skot/bitcrane/doc/bitcrane.jpg

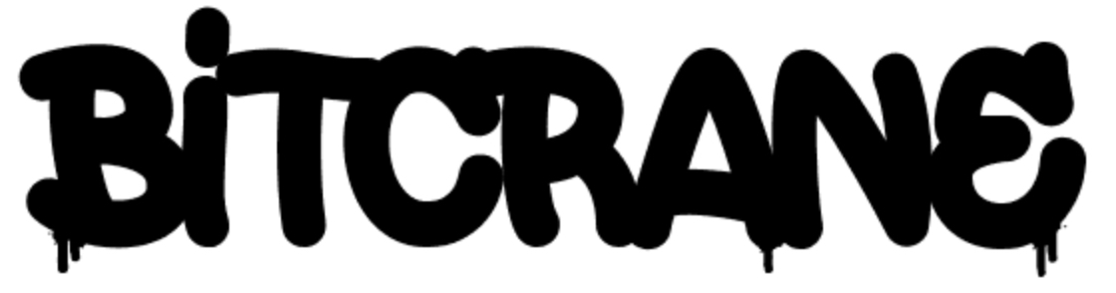
doc/bitcrane.jpg
