skot/bitcrane/3d/RGV0016A.stp

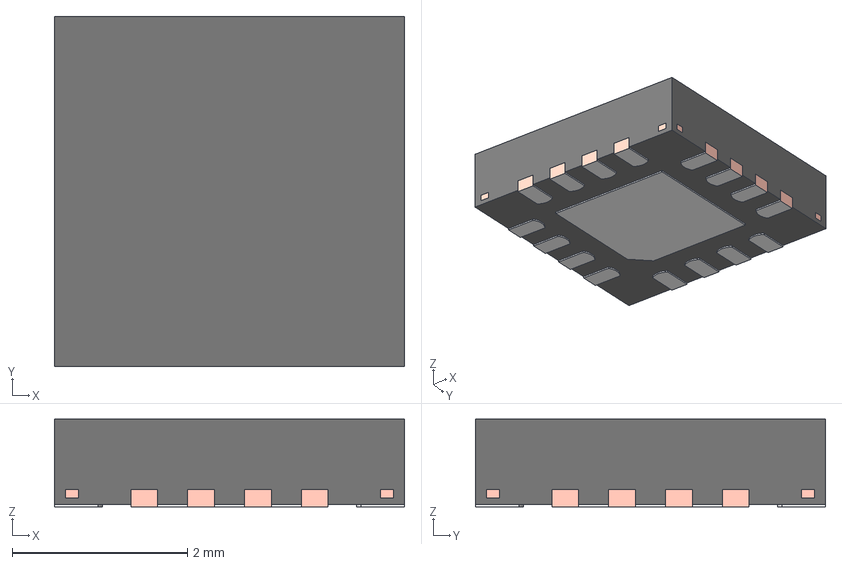
[picture p2: CAD file, 2023-12-09]
3d/RGV0016A.stp
4.00 x 4.00 x 1.00 mm
FRAME
PIN1_AREA
