skot/bitcrane/3d/TSOT-23-5_RIT.step

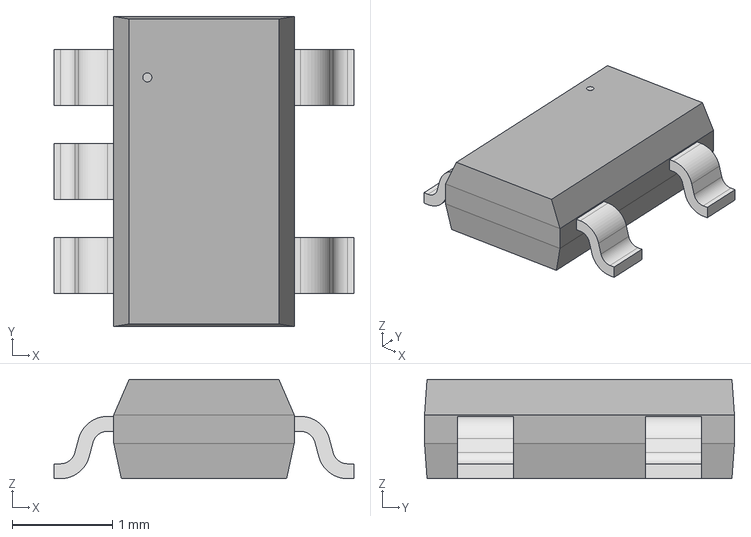
[picture p3: CAD file, 2023-10-24]
3d/TSOT-23-5_RIT.step
3.00 x 3.10 x 0.993 mm
