skot/bitcrane/3d/PowerDI3333-8_Type-UX.STP

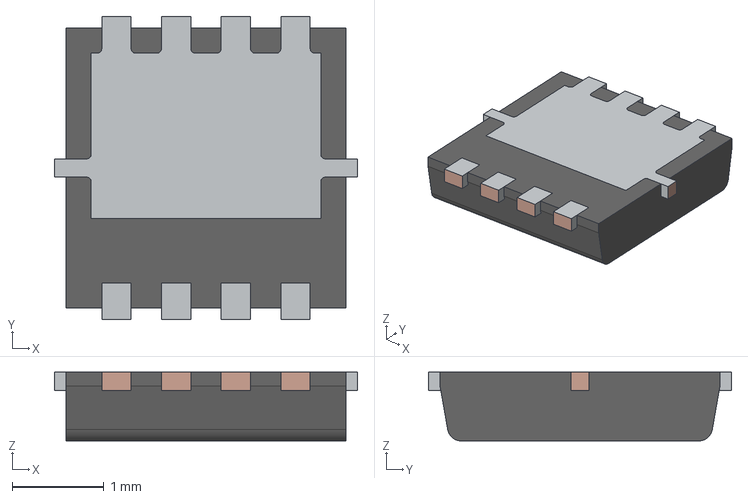
[picture p4: CAD file, 2023-10-24]
3d/PowerDI3333-8_Type-UX.STP
3.30 x 3.30 x 0.75 mm
Mold
LDF
