skot/bitcrane/3d/ABM8W-12.0000MHZ-7-K1Z-T3.step

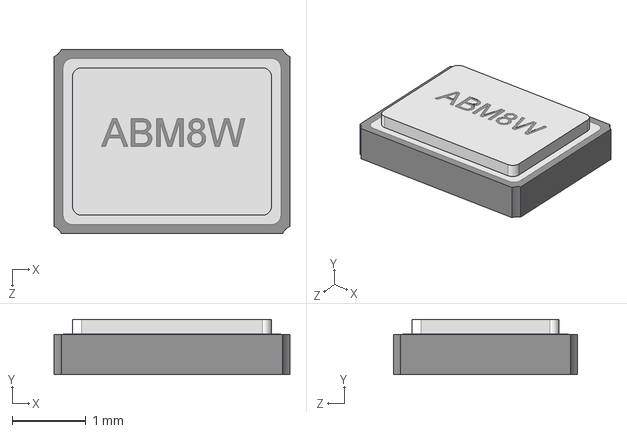
[picture p5: CAD file, 2023-10-23]
3d/ABM8W-12.0000MHZ-7-K1Z-T3.step
3.20 x 0.75 x 2.50 mm
