skot/bitcrane/3d/405C35B12M00000.step

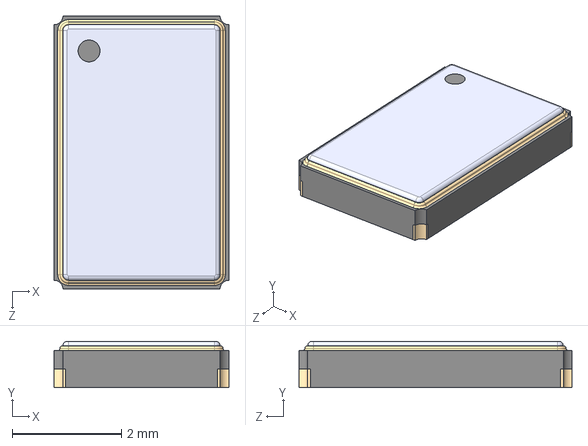
[picture p6: CAD file, 2023-10-23]
3d/405C35B12M00000.step
3.20 x 0.85 x 5.00 mm
