skot/bitcrane/3d/FT4232HQ-REEL.step

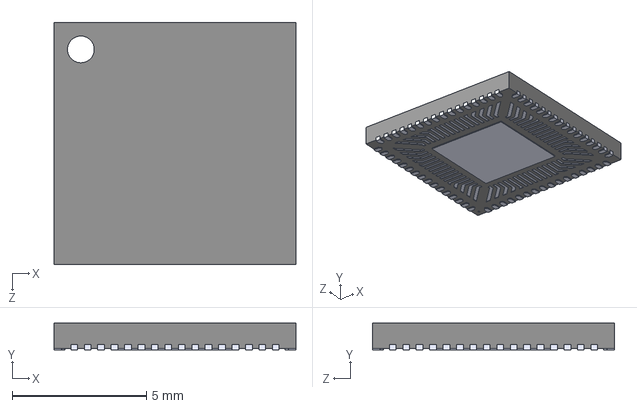
[picture p7: CAD file, 2023-10-23]
3d/FT4232HQ-REEL.step
9.00 x 1.00 x 9.00 mm
