skot/bitcrane/3d/TSSOP8_STM.step

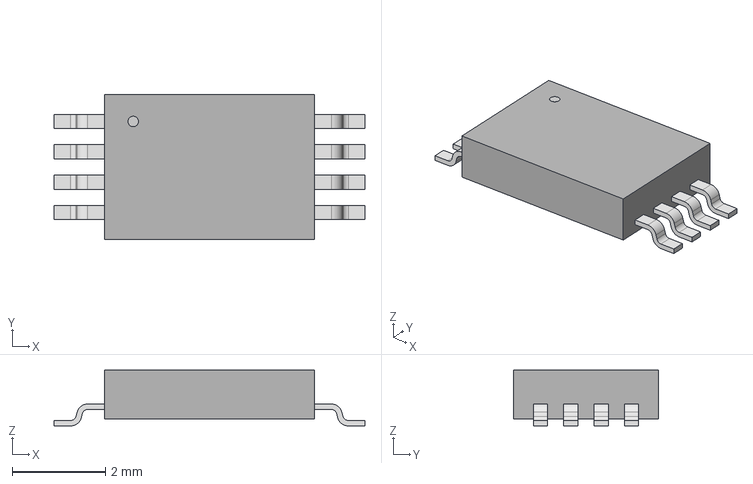
[picture p8: CAD file, 2023-10-23]
3d/TSSOP8_STM.step
6.65 x 3.10 x 1.20 mm
