skot/bitcrane/3d/45558-0003.stp

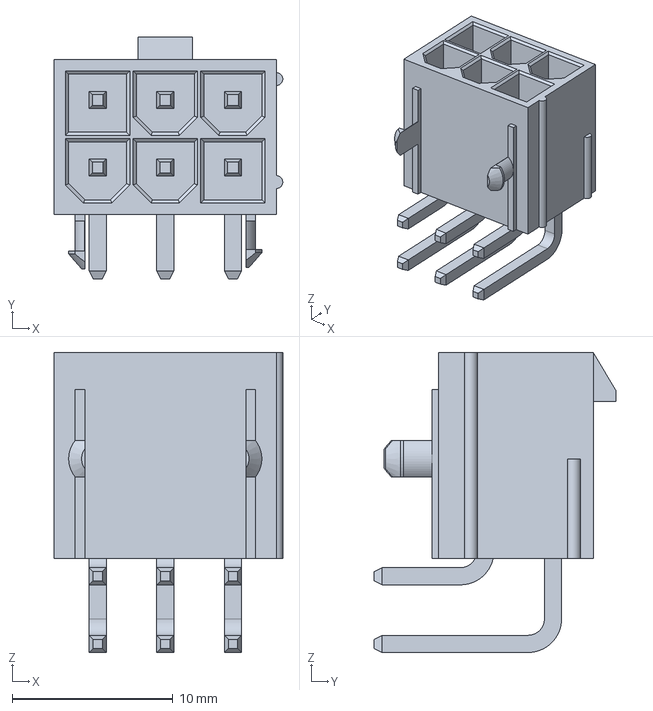
[picture p9: CAD file, 2023-10-24]
3d/45558-0003.stp
14.2 x 15.0 x 18.6 mm
