skot/bitcrane/3d/61900411021.stp

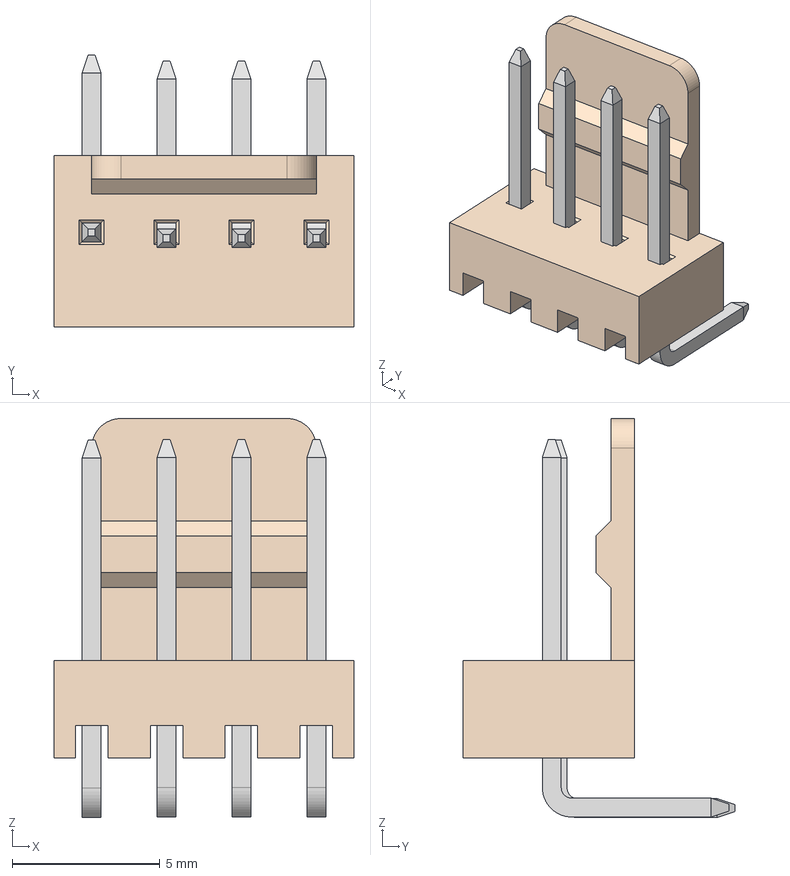
[picture p10: CAD file, 2023-10-24]
3d/61900411021.stp
10.2 x 9.20 x 13.5 mm
6190xx1xx21_PIN x 4
