skot/bitcrane/3d/353180420.igs

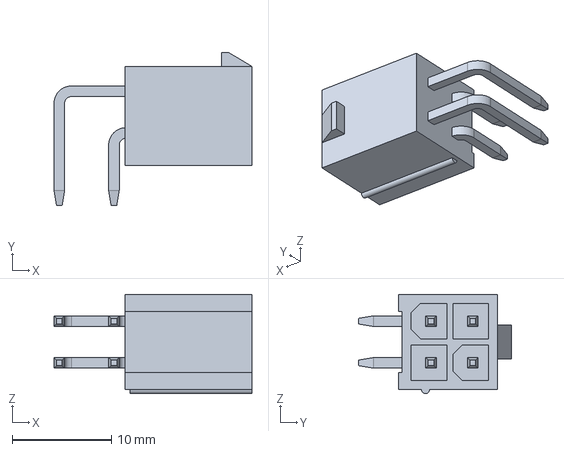
[picture p11: CAD file, 2023-10-24]
3d/353180420.igs
19.9 x 15.4 x 10.0 mm
