skot/bitcrane/bitcrane.kicad_pcb

## KiCad design bitcrane.kicad_pcb (2024-05-23)

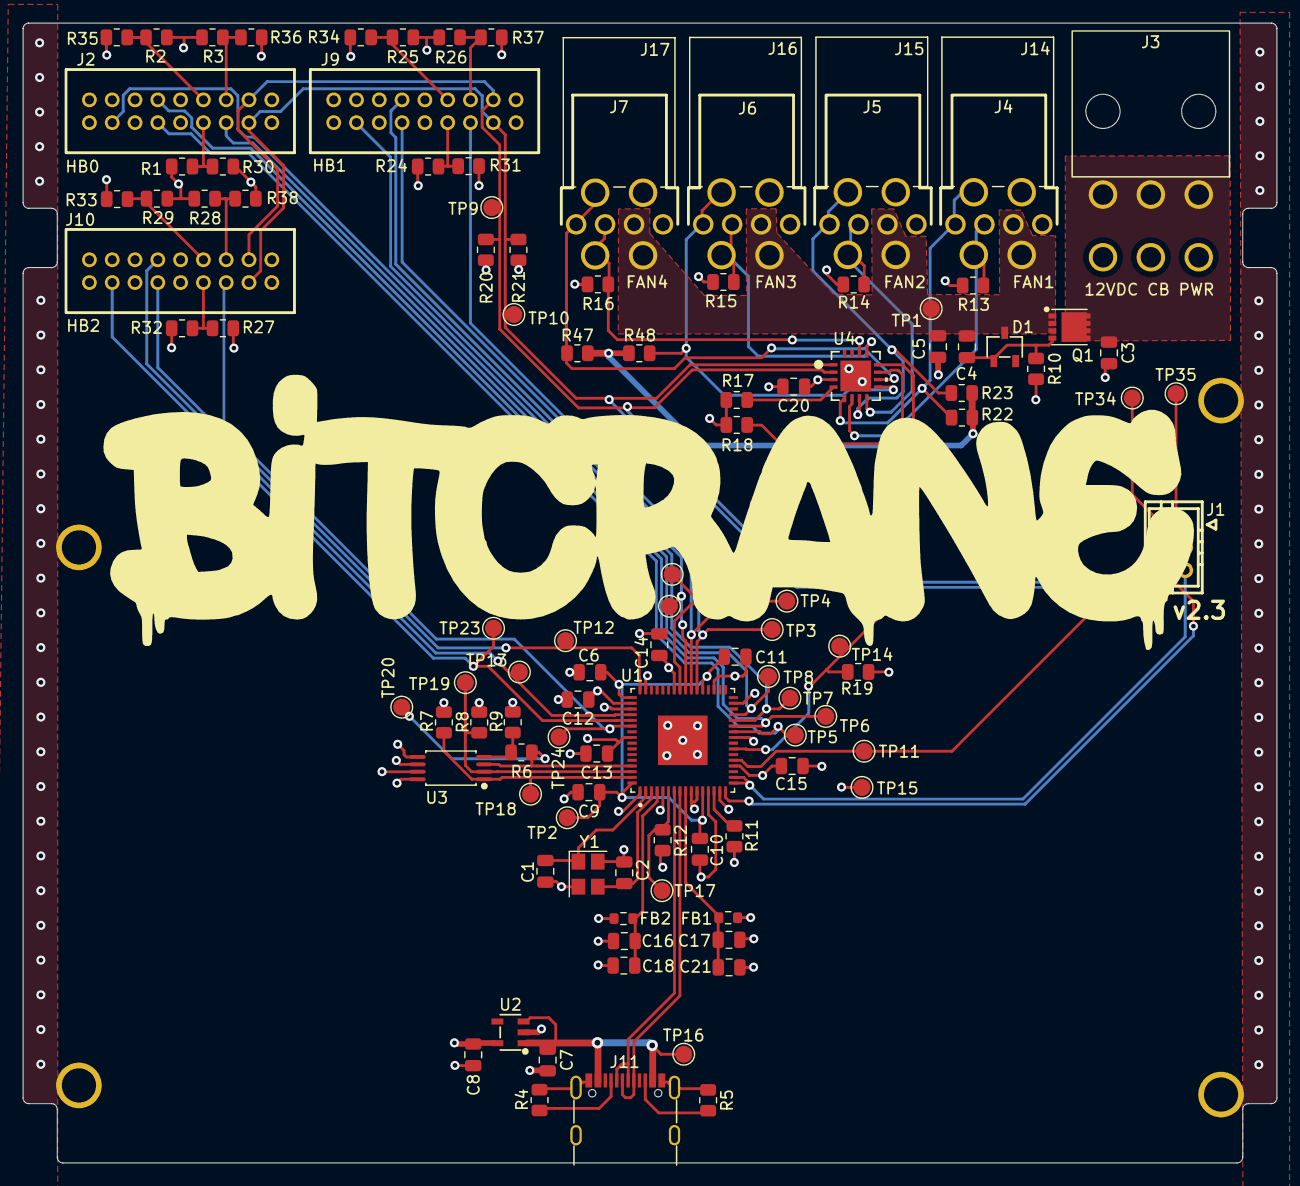
[picture p12: board bitcrane.kicad_pcb from above]

Board: 4 copper layers, 110.0 x 100.0 mm, 113 parts (0 on the bottom side), 58 nets.

Parts:
C1, C2: 27pf; C_0805_2012Metric
C3, C4, C9, C10, C11, C12, C13, C14, C15, C16, C17, C20: 0.1uF; C_0805_2012Metric
C5: 10uF 35V; C_0805_2012Metric
C6: 3.3uF; C_0805_2012Metric
C7, C8: 1uF; C_0805_2012Metric
C18, C21: 47uF; C_0805_2012Metric
D1: LBZX84C12LT1G; SOT-23-3_L2.9-W1.6-P1.90-LS2.8-BR
FB1, FB2: FerriteBead_Small; R_0603_1608Metric
H1, H2, H3, H4: MountingHole_Pad; MountingHole_3mm_Pad
J1: PSU Comm; CONN-TH_6P-P2.00_PHD-2X3A
J2, J9, J10: 2x9P 2mm; CONN-TH_X2026WV-2-09D-46SN
J3: 0455580003; CONN-TH_50362462
J4, J5, J6, J7: 61900411021; CONN-TH_4P-P2.54_HCTL_HC-2510-4AW
J11: USB_C_Receptacle_USB2.0; USB-C-SMD_G-SWITCH_GT-USB-7010ASV
J14, J15, J16, J17: 0353180420; CONN-TH_4P-P4.20_5557-2X2AW
Q1: DMP3013SFV-7; POWERPAK-1212-8_L3.1-W3.1-P0.65-LS3.3-BL
R1, R2, R3, R19, R20, R21, R24, R25, R26, R27, R28, R29, R30, R31, R32, R33, R34, R35, R36, R37, R38: 4.7k; R_0805_2012Metric
R4, R5: 5.1k; R_0805_2012Metric
R6: 2.2k; R_0805_2012Metric
R7, R8, R9, R22, R23, R47, R48: 10k; R_0805_2012Metric
R10, R12: 12k; R_0805_2012Metric
R11: 1k; R_0805_2012Metric
R13, R14, R15, R16: 36k; R_0805_2012Metric
R17: 33k; R_0805_2012Metric
R18: 22k; R_0805_2012Metric
TP1, TP2, TP3, TP4, TP5, TP6, TP7, TP8, TP9, TP10, TP11, TP12, TP13, TP14, TP15, TP16, TP17, TP18, TP19, TP20, TP21, TP22, TP23, TP24, TP34, TP35: TestPoint; TestPoint_Pad_D1.5mm
U1: FT4232HQ; QFN50P900X900X105-65N
U2: RT9080-33GJ5; TSOT-23-5_L2.9-W1.6-P0.95-LS2.8-BL
U3: M93C46-WDW6TP; TSSOP-8_L4.4-W3.0-P0.65-LS6.4-BL
U4: EMC2305; QFN16_4x4MC_MCH
Y1: 12MHz; Crystal_SMD_3225-4Pin_3.2x2.5mm

Connections:
/5V: C7.1, J11.A4B9 (VBUS), J11.B4A9 (VBUS), R22.2, R23.2, R47.2, R48.2, TP16.1, U2.1 (VIN), U2.3 (EN)
/12V: C4.1, C5.1, D1.3 (K), J4.2, J5.2, J6.2, J7.2, J14.2, J15.2, J16.2, J17.2, Q1.1 (S), Q1.2 (S), Q1.3 (S), TP1.1
/A00: J2.8, R2.1, R35.2
/A01: J9.8, R25.1, R34.2
/A02: J10.8, R28.1, R33.2
/A10: J2.7, R1.2, R30.2
/A11: J9.7, R24.2, R31.2
/A12: J10.7, R27.2, R32.2
/A20: J2.6, R3.1, R36.2
/A21: J9.6, R26.1, R37.2
/A22: J10.6, R29.1, R38.2
/FAN_ALERT: R19.1, TP14.1, U1.23 (ADBUS6), U4.12 (~ALERT)
/PLUG0: J2.5, TP8.1, U1.29 (BDBUS3)
/PLUG1: J9.5, TP22.1, U1.41 (CDBUS3)
/PLUG2: J10.5, TP24.1, U1.54 (DDBUS3)
/PSU_EN: J1.5, TP11.1, U1.21 (ADBUS4)
/PWM1: J4.4, J14.4, R22.1, U4.5 (PWM1)
/PWM2: J5.4, J15.4, R23.1, U4.7 (PWM2)
/PWM3: J6.4, J16.4, R47.1, U4.9 (PWM3)
/PWM4: J7.4, J17.4, R48.1, U4.13 (PWM4)
/RST0: J2.15, TP7.1, U1.28 (BDBUS2)
/RST1: J9.15, TP21.1, U1.40 (CDBUS2)
/RST2: J10.15, TP23.1, U1.53 (DDBUS2)
/RXD0: J2.12, TP6.1, U1.27 (BDBUS1)
/RXD1: J9.12, TP4.1, U1.39 (CDBUS1)
/RXD2: J10.12, TP13.1, U1.52 (DDBUS1)
/SCL: J1.6, J2.4, J9.4, J10.4, R20.1, TP9.1, U1.16 (ADBUS0), U4.2 (SMCLK)
/SDA: J1.3, J2.3, J9.3, J10.3, R21.1, TP10.1, U1.17 (ADBUS1), U1.18 (ADBUS2), U4.1 (SMDATA)
/TACH1: J4.3, J14.3, R13.2, U4.6 (TACH1)
/TACH2: J5.3, J15.3, R14.2, U4.8 (TACH2)
/TACH3: J6.3, J16.3, R15.2, U4.10 (TACH3)
/TACH4: J7.3, J17.3, R16.2, U4.14 (TACH4)
/TXD0: J2.11, TP5.1, U1.26 (BDBUS0)
/TXD1: J9.11, TP3.1, U1.38 (CDBUS0)
/TXD2: J10.11, TP12.1, U1.48 (DDBUS0)
GND: C1.2, C2.2, C3.2, C5.2, C6.2, C7.2, C8.2, C9.2, C10.2, C11.2, C12.2, C13.2, C14.2, C15.2, C16.2, C17.2, C18.2, C20.2, C21.2, H1.1, H2.1, H3.1, H4.1, J1.2, J2.1, J2.2, J2.9, J2.10, J2.13, J2.14, J3.4, J3.5, J3.6, J4.1, J5.1, J6.1, J7.1, J9.1, J9.2, J9.9, J9.10, J9.13, J9.14, J10.1, J10.2, J10.9, J10.10, J10.13, J10.14, J11.1 (SHELL), J11.2 (SHELL), J11.3 (SHELL), J11.4 (SHELL), J11.A1B12 (GND), J11.B1A12 (GND), J14.1, J15.1, J16.1, J17.1, R1.1, R2.2, R3.2, R4.1, R5.1, R10.2, R12.1, R24.1, R25.2, R26.2, R27.1, R28.2, R29.2, U1.1 (GND), U1.5 (GND), U1.10 (AGND), U1.11 (GND), U1.13 (TEST), U1.15 (GND), U1.25 (GND), U1.35 (GND), U1.47 (GND), U1.51 (GND), U1.65 (EPAD), U2.2 (GND), U3.5 (VSS), U3.7 (DU), U4.17 (GND), Y1.2 (GND), Y1.4 (GND__1)
unnamed: C3.1, J3.1, J3.2, J3.3, Q1.5 (D), Q1.6 (D), Q1.7 (D), Q1.8 (D)
unnamed: C4.2, D1.1 (A), Q1.4 (G), R10.1
unnamed: J1.1, TP35.1
unnamed: J1.4, TP34.1
unnamed: J11.A5 (CC1), R4.2
unnamed: J11.B5 (CC2), R5.2
unnamed: J11.A7 (DN1), J11.B7 (DN2), U1.7 (DM)
unnamed: J11.A6 (DP1), J11.B6 (DP2), U1.8 (DP)
unnamed: R8.1, TP19.1, U1.62 (EECLK), U3.2 (CLK)
unnamed: R7.1, TP18.1, U1.63 (EECS), U3.1 (CS)
unnamed: R6.2, TP20.1, U1.61 (EEDATA), U3.3 (D)
unnamed: C1.1, U1.2 (OSCI), Y1.1
unnamed: C2.1, U1.3 (OSCO), Y1.3
unnamed: R12.2, TP17.1, U1.6 (REF)
unnamed: R11.2, U1.14 (RESET#)
unnamed: C16.1, C18.1, FB2.2, U1.4 (VPHY)
unnamed: C17.1, C21.1, FB1.2, U1.9 (VPLL)
unnamed: R6.1, R9.1, U3.4 (Q)
unnamed: R17.1, U4.4 (ADDR_SEL)
unnamed: R18.1, U4.11 (CLK)
VCCIO: C8.1, C12.1, C13.1, C14.1, C15.1, C20.1, FB1.1, FB2.1, J2.16, J9.16, J10.16, R7.2, R8.2, R9.2, R11.1, R13.1, R14.1, R15.1, R16.1, R17.2, R18.2, R19.2, R20.2, R21.2, R30.1, R31.1, R32.1, R33.1, R34.1, R35.1, R36.1, R37.1, R38.1, TP15.1, U1.20 (VCCIO), U1.31 (VCCIO), U1.42 (VCCIO), U1.50 (VREGIN), U1.56 (VCCIO), U2.5 (VOUT), U3.6 (ORG), U3.8 (VCC), U4.3 (VDD)
VCORE: C6.1, C9.1, C10.1, C11.1, TP2.1, U1.12 (VCORE), U1.37 (VCORE), U1.49 (VREGOUT), U1.64 (VCORE)
