skot/bitcrane/(threads)

Thread 2 (2023-12-02):

FT4232 doesn't support I2C on busses C & D

skot, 2023-12-02:
oops.
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
Only the busses with "MPSSE" can do I2C..
The solution here is to use a I2C multiplexer like the TCA9548A.

While you're at it, you might as well add the other two hashboards.

Closed 2023-12-10.

Thread 4 (2023-12-07):

EMC2305 FAN_ALERT pin requires pullup

skot, 2023-12-07:
> 3.1.8 ALERT - SMBUS ALERT PIN
This pin indicates when an out of limits or other error condition has occurred. Active low interrupt - requires external pull-up resistor

Closed 2023-12-10.

Thread 9 (2024-01-15):

Not all FT4232 UART pins are bidirectional GPIO

skot, 2024-01-15:
from @johnny9;

according to the [PyFTDI library docs](https://eblot.github.io/pyftdi/api/uart.html#uart-gpio), not all FT4232 UART pins can be used as bidirectional GPIO.

This might be a problem with the bitcrane RST and PLUG hashboard data connector pins

skot, 2024-03-20:
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

skot, 2024-03-20:
RST is a control board _output_
PLUG is a control board _input_

skot, 2024-05-06:
fixed in v2.2

Closed 2024-05-06.

Thread 10 (2024-03-28):

EMC2305 pwm signal needs pullups

skot, 2024-03-28:
probably to 5V

skot, 2024-05-06:
fixed in v2.3

Closed 2024-05-06.

Thread 13 (2024-06-17):

FT4232 appears to need an additional pin connected for I2C clock stretching mode

skot, 2024-06-17:
We need clock stretching mode to communicate with the PIC on S19j and earlier hashboards.. According to the [pyftdi docs](https://eblot.github.io/pyftdi/api/i2c.html#pyftdi.i2c.I2cController), the FT4232:
```
SCK should be connected to A*BUS0, and A*BUS7 if clock stretching mode is enabled
```
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

This should be U1 pins 16 & 24 pins connected. Ideally this can be hacked on a Bitcrane v2.3 manually to test if it indeed works.

lef149, 2024-06-18:
Clock streching[](https://eblot.github.io/pyftdi/api/i2c.html#clock-streching)
Clock stretching is supported through a hack that re-uses the JTAG adaptative clock mode designed for ARM devices. FTDI HW drives SCL on AD0 (BD0), and samples the SCL line on : the 8th pin of a port AD7 (BD7).

When a FTDI device without an open collector capability is used (FT2232H, FT4232H, FT4232HA) the current sourced from AD0 may prevent proper sampling ofthe SCL line when the slave attempts to strech the clock. It is therefore recommended to add a low forward voltage drop diode to AD0 to prevent AD0 to source current to the SCL bus. See the wiring section.

lef149, 2024-06-21:
Connected pins 16 and 24 and was able to get clock stretching to work and read the pic chip. you do have to play with delays but it seems like you have to no matter what. I did not have to change the clock speed with the right delays.
