skot/bitcrane/(commit log)

2023-10-23 initial import
    [405C35B12M00000.step, ABM8W-12.0000MHZ-7-K1Z-T3.step, FT4232HQ-REEL.step, TSSOP8_STM.step, bitcrane.kicad_pcb, bitcrane.kicad_sch]
2023-10-24 added most of the schematic
    [353180420.igs, bitcrane.kicad_pcb, bitcrane.kicad_sch]
2023-10-24 added the fan controller IC. silkscreen cleanup
    [bitcrane.kicad_pcb, bitcrane.kicad_sch]
2023-10-24 cleanup. updated render
    [bitcrane.kicad_pcb]
2023-11-06 added test points, filled out BOM, ran DRC
    [bitcrane BOM.xlsx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]
2023-11-06 couple small gerber fixes. updated render
    [bitcrane-B_Cu.gbr, bitcrane-B_Mask.gbr, bitcrane-B_Silkscreen.gbr, bitcrane-Edge_Cuts.gbr, bitcrane-F_Cu.gbr, bitcrane-F_Mask.gbr, bitcrane-F_Paste.gbr, bitcrane-F_Silkscreen.gbr]
2023-11-10 fixed 12V label position ;P
    [bitcrane.kicad_sch]
2023-12-07 added fixes for #2 #3 #4 to schematic. still needs to be adjusted in layout
    [bitcrane.kicad_pcb, bitcrane.kicad_sch]
2023-12-07 added fix for #5 to schematic. still needs PCB work
    [bitcrane.kicad_pcb, bitcrane.kicad_sch]
2023-12-08 routed v2 changes
    [bitcrane.kicad_pcb, bitcrane.kicad_sch]
2023-12-09 switched to 3 HB connectors. added I2C hub. routed
    [RGV0016A.stp, bitcrane.kicad_pcb, bitcrane.kicad_sch]
2023-12-09 ran DRC, fixed errors, generated gerbers, generated BOM
    [bitcrane BOM.xlsx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]
2023-12-10 removed paste from THT parts :P
    [bitcrane-B_Cu.gbr, bitcrane-B_Mask.gbr, bitcrane-B_Silkscreen.gbr, bitcrane-Edge_Cuts.gbr, bitcrane-F_Cu.gbr, bitcrane-F_Mask.gbr, bitcrane-F_Paste.gbr, bitcrane-F_Silkscreen.gbr]
2023-12-10 last minute fix for #1
    [bitcrane-B_Cu.gbr, bitcrane-B_Mask.gbr, bitcrane-B_Silkscreen.gbr, bitcrane-Edge_Cuts.gbr, bitcrane-F_Cu.gbr, bitcrane-F_Mask.gbr, bitcrane-F_Paste.gbr, bitcrane-F_Silkscreen.gbr]
2024-01-11 fix for #8. regenerated gerbers. bump version to 2.1
    [bitcrane-B_Cu.gbr, bitcrane-B_Mask.gbr, bitcrane-B_Silkscreen.gbr, bitcrane-Edge_Cuts.gbr, bitcrane-F_Cu.gbr, bitcrane-F_Mask.gbr, bitcrane-F_Paste.gbr, bitcrane-F_Silkscreen.gbr]
2024-03-20 fix for #9. regenerated gerbers. bumped version to 2.2
    [bitcrane-B_Cu.gbr, bitcrane-B_Mask.gbr, bitcrane-B_Silkscreen.gbr, bitcrane-Edge_Cuts.gbr, bitcrane-F_Cu.gbr, bitcrane-F_Mask.gbr, bitcrane-F_Paste.gbr, bitcrane-F_Silkscreen.gbr]
2024-04-08 adding iBOM for assembly
2024-05-03 fix for #10 small DRC fixes. updated to v2.3
    [bitcrane.kicad_pcb, bitcrane.kicad_sch]
2024-05-06 added PCB labels for Fans and Hashboards. Starting to add LCSC part numbers
    [bitcrane.kicad_pcb, bitcrane.kicad_sch]
2024-05-06 added almost all LCSC part numbers
    [bitcrane.kicad_pcb, bitcrane.kicad_sch]
2024-05-06 added gerbers and BOM
    [bitcrane BOM.xlsx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]
2024-05-06 Updated all footprints for JLCPCB parts. Added JLCPCB BOM and CPL
    [bitcrane-B_Cu.gbr, bitcrane-B_Mask.gbr, bitcrane-B_Silkscreen.gbr, bitcrane-Edge_Cuts.gbr, bitcrane-F_Cu.gbr, bitcrane-F_Mask.gbr, bitcrane-F_Paste.gbr, bitcrane-F_Silkscreen.gbr]
2024-05-07 actually add manufacturing files this time..
    [bitcrane BOM JLCPCB.csv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]
2024-05-23 changed Y1 LCSC partnumber for #12 Changed C18/C21 value in schematic (thanks @BeeEvolved)
    [bitcrane.kicad_pcb, bitcrane.kicad_sch]
